carlosefr/spinner-mouse/artwork/cover.png

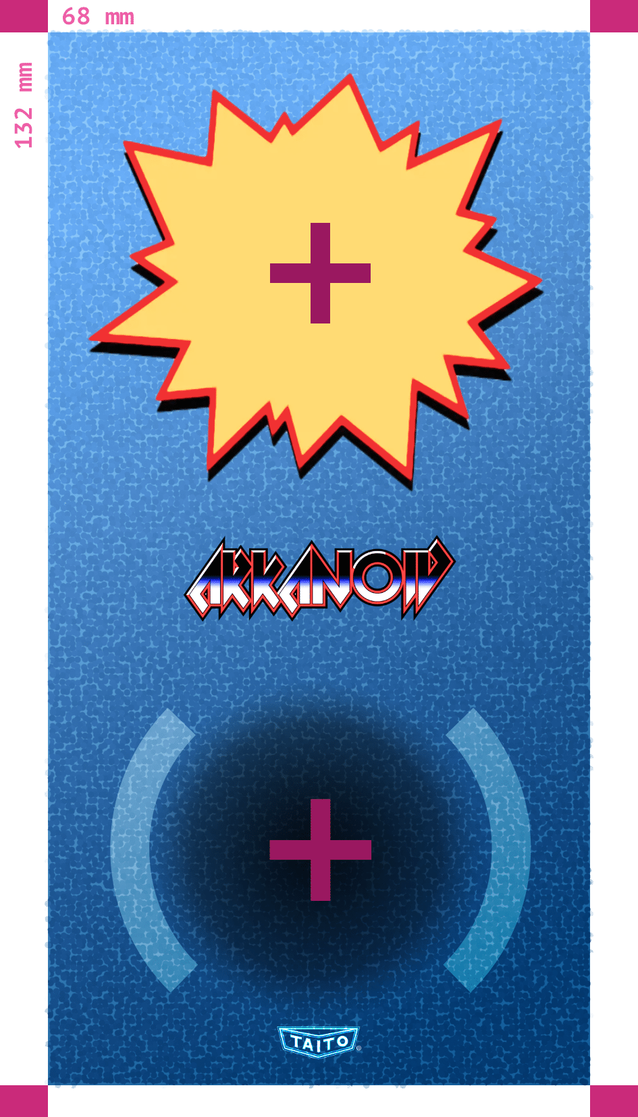
artwork/cover.png
