carlosefr/spinner-mouse/(commit log)

2024-02-29 Additional button and optional external button (pedal)
2024-03-01 Output events at 250Hz, and some cleanup
2024-03-02 Blink LED with a jack is inserted/removed
2024-03-02 Make feedback LED more visible
2024-03-03 Added simple circuit diagrams
2025-01-04 Allow swapping left/right buttons via serial
    Sega's "Rough Racer" (1990) has the accelerator function in the secondary button and needs that button to be mapped to the left mouse button.
    [SpinnerMouse.ino]
